Queens-Rocket-Engineering-Team/GSE-ESP32/QRET-ESP32.kicad_pcb

## KiCad design QRET-ESP32.kicad_pcb (2026-04-01)

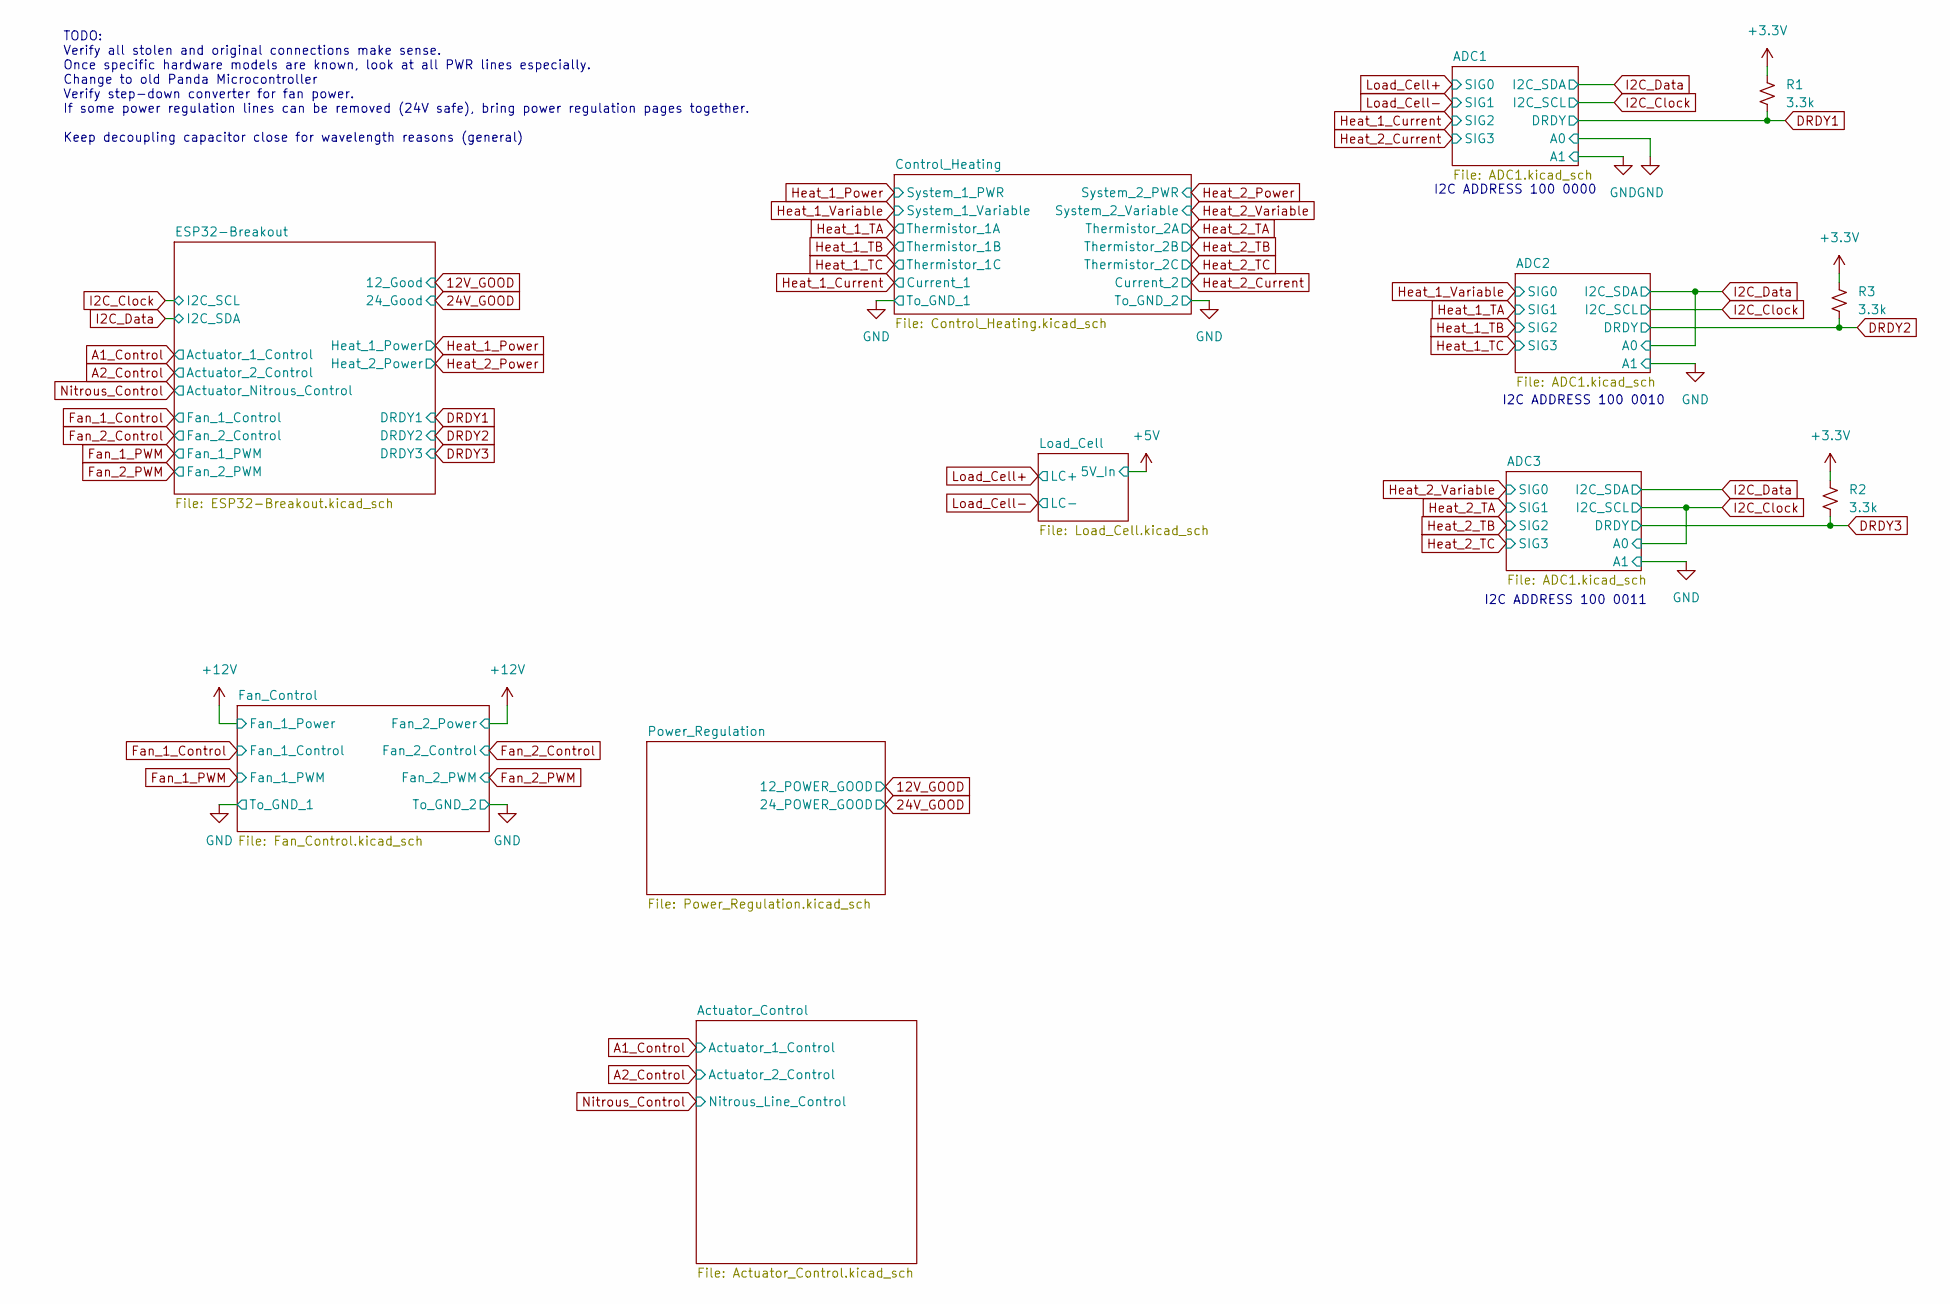
[picture p1: schematic QRET-ESP32.kicad_sch]

Parts:
R1, R2, R3: 3.3k; R_0402_1005Metric

Connections:
DRDY1: R1.2; also elsewhere on the board
DRDY2: R3.2; also elsewhere on the board
DRDY3: R2.2; also elsewhere on the board

Notes on the sheet:
TODO: Verify all stolen and original connections make sense. Once specific hardware models are known, look at all PWR lines especially. Change to old Panda Microcontroller Verify step-down converter for fan power. If some power regulation lines can be removed (24V safe), bring power regulation page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
I2C ADDRESS 100 0000
I2C ADDRESS 100 0011
I2C ADDRESS 100 0010

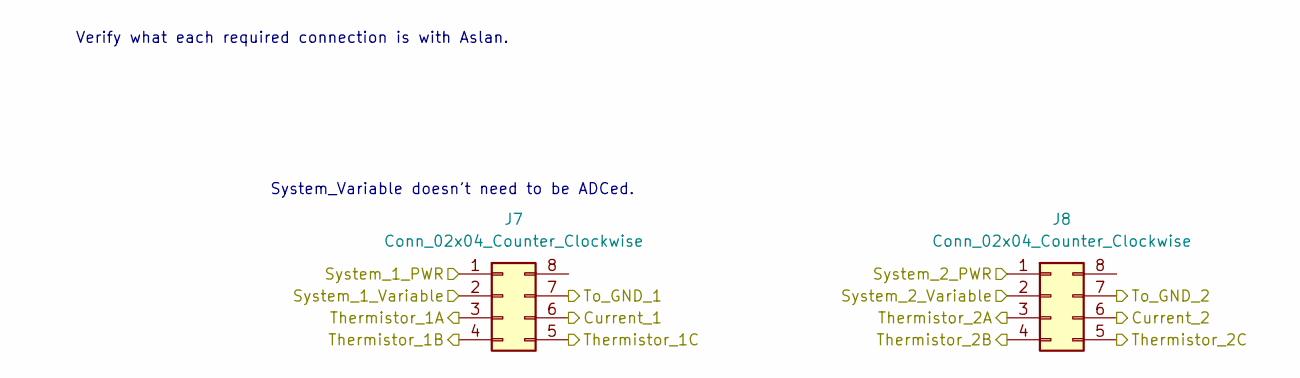
[picture p2: schematic Control_Heating.kicad_sch]

Parts:
J7, J8: Conn_02x04_Counter_Clockwise; JST_J2100_B08B-J21DK-GGXR_2x04_P2.50x4.00mm_Vertical

Connections:
Heat_1_Current: J7.6; also elsewhere on the board
Heat_1_Power: J7.1; also elsewhere on the board
Heat_1_TA: J7.3; also elsewhere on the board
Heat_1_TB: J7.4; also elsewhere on the board
Heat_1_TC: J7.5; also elsewhere on the board
Heat_1_Variable: J7.2; also elsewhere on the board
Heat_2_Current: J8.6; also elsewhere on the board
Heat_2_Power: J8.1; also elsewhere on the board
Heat_2_TA: J8.3; also elsewhere on the board
Heat_2_TB: J8.4; also elsewhere on the board
Heat_2_TC: J8.5; also elsewhere on the board
Heat_2_Variable: J8.2; also elsewhere on the board

Notes on the sheet:
Verify what each required connection is with Aslan.
System_Variable doesn't need to be ADCed.

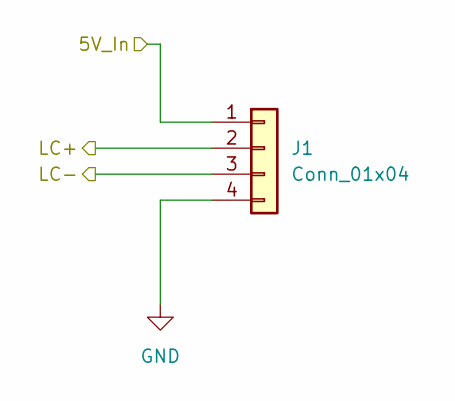
[picture p3: schematic Load_Cell.kicad_sch]

Parts:
J1: Conn_01x04; JST_EH_B4B-EH-A_1x04_P2.50mm_Vertical

Connections:
+5V: J1.1; also elsewhere on the board
Load_Cell+: J1.2; also elsewhere on the board
Load_Cell-: J1.3; also elsewhere on the board

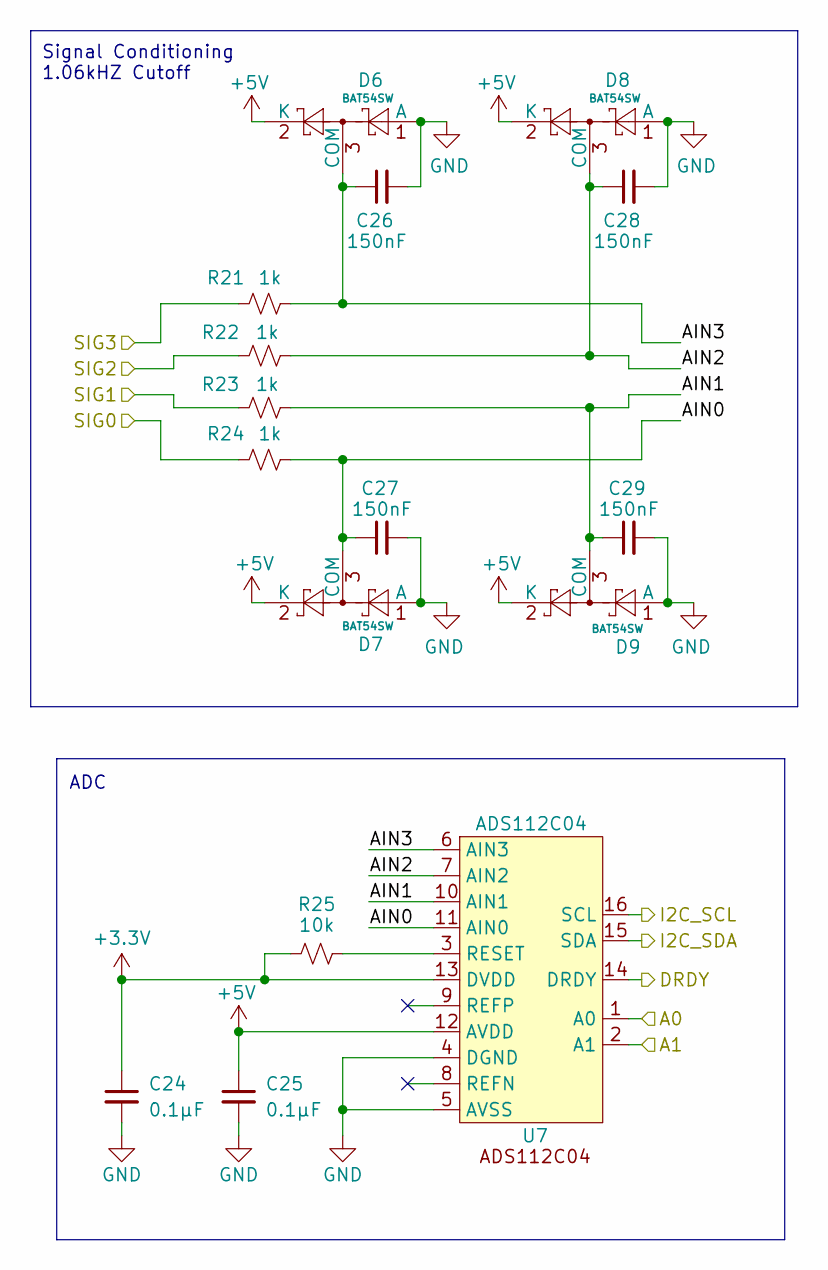
[picture p4: schematic ADC1.kicad_sch]

Parts:
C24, C25: 0.1μF; C_0402_1005Metric; MPN CL05B104KO5NNNC; LCSC C307331
C26, C27, C28, C29: 150nF; C_0402_1005Metric; LCSC C576725
D6, D7, D8, D9: BAT54SW; SOT-323_SC-70; LCSC C83575
R21, R22, R23, R24: 1k; R_0402_1005Metric
R25: 10k; R_0402_1005Metric; MPN 0402WGJ0103TCE; LCSC C25531
U7: ADS112C04; TSSOP-16_4.4x5mm_P0.65mm; MPN ADS112C04IPWR; LCSC C701615

Connections:
+5V: C25.1, D6.2 (K), D7.2 (K), D8.2 (K), D9.2 (K), U7.12 (AVDD); also elsewhere on the board
/ADC1/AIN0: C27.1, D7.3 (COM), R24.2, U7.11 (AIN0)
/ADC1/AIN1: C29.1, D9.3 (COM), R23.2, U7.10 (AIN1)
/ADC1/AIN2: C28.1, D8.3 (COM), R22.2, U7.7 (AIN2)
/ADC1/AIN3: C26.1, D6.3 (COM), R21.2, U7.6 (AIN3)
DRDY1: U7.14 (DRDY); also elsewhere on the board
Heat_1_Current: R22.1; also elsewhere on the board
Heat_2_Current: R21.1; also elsewhere on the board
I2C_Clock: U7.16 (SCL); also elsewhere on the board
I2C_Data: U7.15 (SDA); also elsewhere on the board
Load_Cell+: R24.1; also elsewhere on the board
Load_Cell-: R23.1; also elsewhere on the board
unnamed: R25.2, U7.3 (RESET)

Parts of its further copies:
C30, C31, C36, C37: 0.1μF; C_0402_1005Metric; MPN CL05B104KO5NNNC; LCSC C307331
C32, C33, C34, C35, C38, C39, C40, C41: 150nF; C_0402_1005Metric; LCSC C576725
D10, D11, D12, D13, D14, D15, D16, D17: BAT54SW; SOT-323_SC-70; LCSC C83575
R26, R27, R28, R29, R31, R32, R33, R34: 1k; R_0402_1005Metric
R30, R35: 10k; R_0402_1005Metric; MPN 0402WGJ0103TCE; LCSC C25531
U8, U9: ADS112C04; TSSOP-16_4.4x5mm_P0.65mm; MPN ADS112C04IPWR; LCSC C701615

Connections of its further copies:
+5V: C31.1, C37.1, D10.2 (K), D11.2 (K), D12.2 (K), D13.2 (K), D14.2 (K), D15.2 (K), D16.2 (K), D17.2 (K), U8.12 (AVDD), U9.12 (AVDD); also elsewhere on the board
/ADC2/AIN0: C33.1, D11.3 (COM), R29.2, U8.11 (AIN0)
/ADC2/AIN1: C35.1, D13.3 (COM), R28.2, U8.10 (AIN1)
/ADC2/AIN2: C34.1, D12.3 (COM), R27.2, U8.7 (AIN2)
/ADC2/AIN3: C32.1, D10.3 (COM), R26.2, U8.6 (AIN3)
/ADC3/AIN0: C39.1, D15.3 (COM), R34.2, U9.11 (AIN0)
/ADC3/AIN1: C41.1, D17.3 (COM), R33.2, U9.10 (AIN1)
/ADC3/AIN2: C40.1, D16.3 (COM), R32.2, U9.7 (AIN2)
/ADC3/AIN3: C38.1, D14.3 (COM), R31.2, U9.6 (AIN3)
DRDY2: U8.14 (DRDY); also elsewhere on the board
DRDY3: U9.14 (DRDY); also elsewhere on the board
Heat_1_TA: R28.1; also elsewhere on the board
Heat_1_TB: R27.1; also elsewhere on the board
Heat_1_TC: R26.1; also elsewhere on the board
Heat_1_Variable: R29.1; also elsewhere on the board
Heat_2_TA: R33.1; also elsewhere on the board
Heat_2_TB: R32.1; also elsewhere on the board
Heat_2_TC: R31.1; also elsewhere on the board
Heat_2_Variable: R34.1; also elsewhere on the board
I2C_Clock: U8.16 (SCL), U9.1 (A0), U9.16 (SCL); also elsewhere on the board
I2C_Data: U8.1 (A0), U8.15 (SDA), U9.15 (SDA); also elsewhere on the board
unnamed: R30.2, U8.3 (RESET)
unnamed: R35.2, U9.3 (RESET)

Notes on the sheet:
ADC
Signal Conditioning 1.06kHZ Cutoff

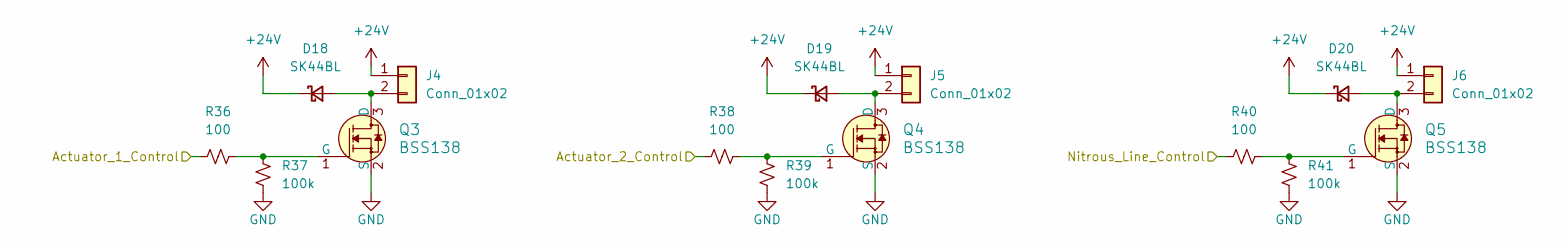
[picture p5: schematic Actuator_Control.kicad_sch]

Parts:
D18, D19, D20: SK44BL; D_SMB; MPN SK44BL-TP; LCSC C151740
J4, J5, J6: Conn_01x02; JST_EH_B2B-EH-A_1x02_P2.50mm_Vertical
Q3, Q4, Q5: BSS138; SOT-23-3; MPN BSS138; LCSC C8490
R36, R38, R40: 100; R_0402_1005Metric; MPN 0402WGF1000TCE; LCSC C25076
R37, R39, R41: 100k; R_0603_1608Metric; MPN 0402WGJ0104TCE; LCSC C25530

Connections:
+24V: D18.1 (K), D19.1 (K), D20.1 (K), J4.1, J5.1, J6.1; also elsewhere on the board
A1_Control: R36.1; also elsewhere on the board
A2_Control: R38.1; also elsewhere on the board
unnamed: D18.2 (A), J4.2, Q3.3 (D)
unnamed: D19.2 (A), J5.2, Q4.3 (D)
unnamed: D20.2 (A), J6.2, Q5.3 (D)
unnamed: Q3.1 (G), R36.2, R37.1
unnamed: Q4.1 (G), R38.2, R39.1
unnamed: Q5.1 (G), R40.2, R41.1
Nitrous_Control: R40.1; also elsewhere on the board

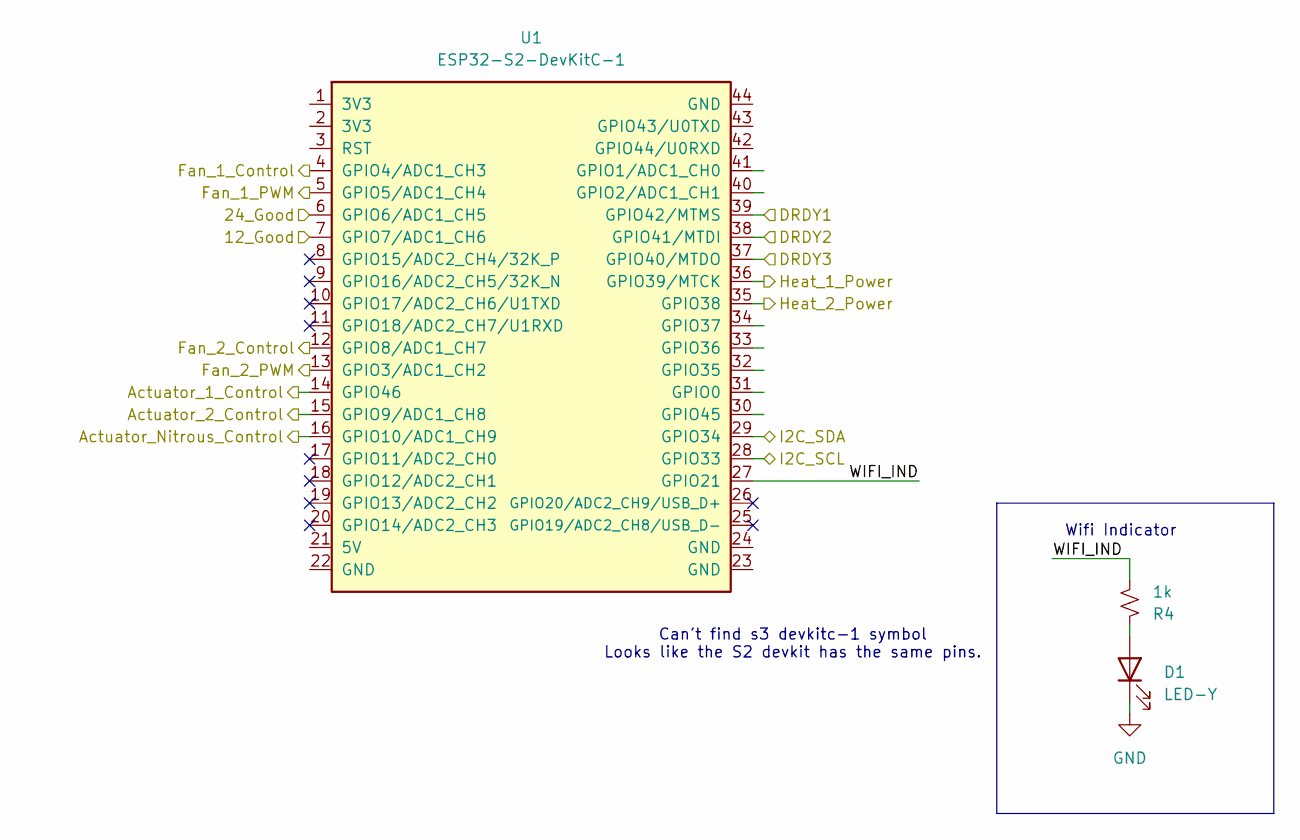
[picture p6: schematic ESP32-Breakout.kicad_sch]

Parts:
D1: LED-Y; LED_0805_2012Metric; LCSC C2296
R4: 1k; R_0402_1005Metric
U1: ESP32-S2-DevKitC-1

Connections:
12V_GOOD: U1.7 (GPIO7/ADC1_CH6); also elsewhere on the board
24V_GOOD: U1.6 (GPIO6/ADC1_CH5); also elsewhere on the board
/ESP32-Breakout/WIFI_IND: R4.2, U1.27 (GPIO21)
A1_Control: U1.14 (GPIO46); also elsewhere on the board
A2_Control: U1.15 (GPIO9/ADC1_CH8); also elsewhere on the board
DRDY1: U1.39 (GPIO42/MTMS); also elsewhere on the board
DRDY2: U1.38 (GPIO41/MTDI); also elsewhere on the board
DRDY3: U1.37 (GPIO40/MTDO); also elsewhere on the board
Fan_1_Control: U1.4 (GPIO4/ADC1_CH3); also elsewhere on the board
Fan_1_PWM: U1.5 (GPIO5/ADC1_CH4); also elsewhere on the board
Fan_2_Control: U1.12 (GPIO8/ADC1_CH7); also elsewhere on the board
Fan_2_PWM: U1.13 (GPIO3/ADC1_CH2); also elsewhere on the board
Heat_1_Power: U1.36 (GPIO39/MTCK); also elsewhere on the board
Heat_2_Power: U1.35 (GPIO38); also elsewhere on the board
I2C_Clock: U1.28 (GPIO33); also elsewhere on the board
I2C_Data: U1.29 (GPIO34); also elsewhere on the board
unnamed: D1.2 (A), R4.1
Nitrous_Control: U1.16 (GPIO10/ADC1_CH9); also elsewhere on the board

Notes on the sheet:
Can't find s3 devkitc-1 symbol Looks like the S2 devkit has the same pins.
Wifi Indicator

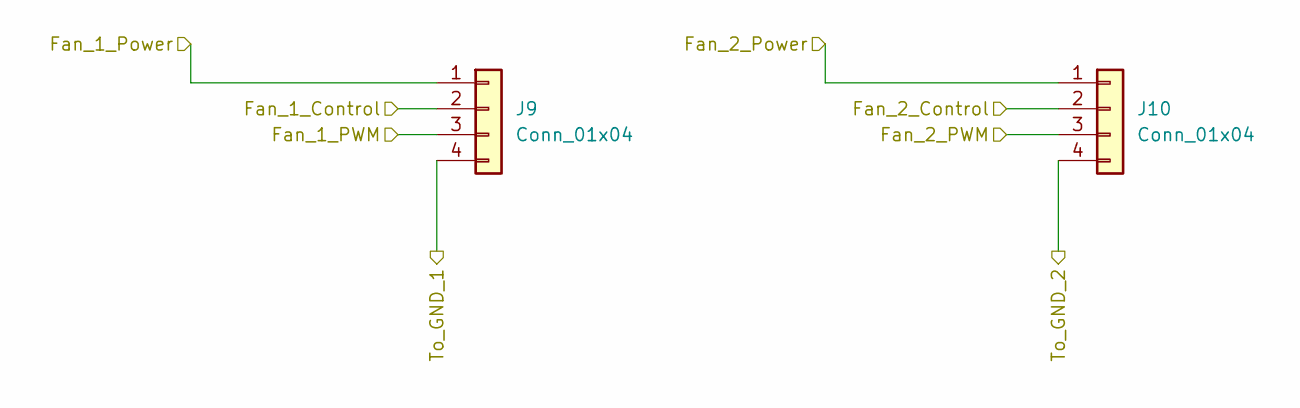
[picture p7: schematic Fan_Control.kicad_sch]

Parts:
J9, J10: Conn_01x04; JST_EH_B4B-EH-A_1x04_P2.50mm_Vertical

Connections:
+12V: J9.1, J10.1; also elsewhere on the board
Fan_1_Control: J9.2; also elsewhere on the board
Fan_1_PWM: J9.3; also elsewhere on the board
Fan_2_Control: J10.2; also elsewhere on the board
Fan_2_PWM: J10.3; also elsewhere on the board

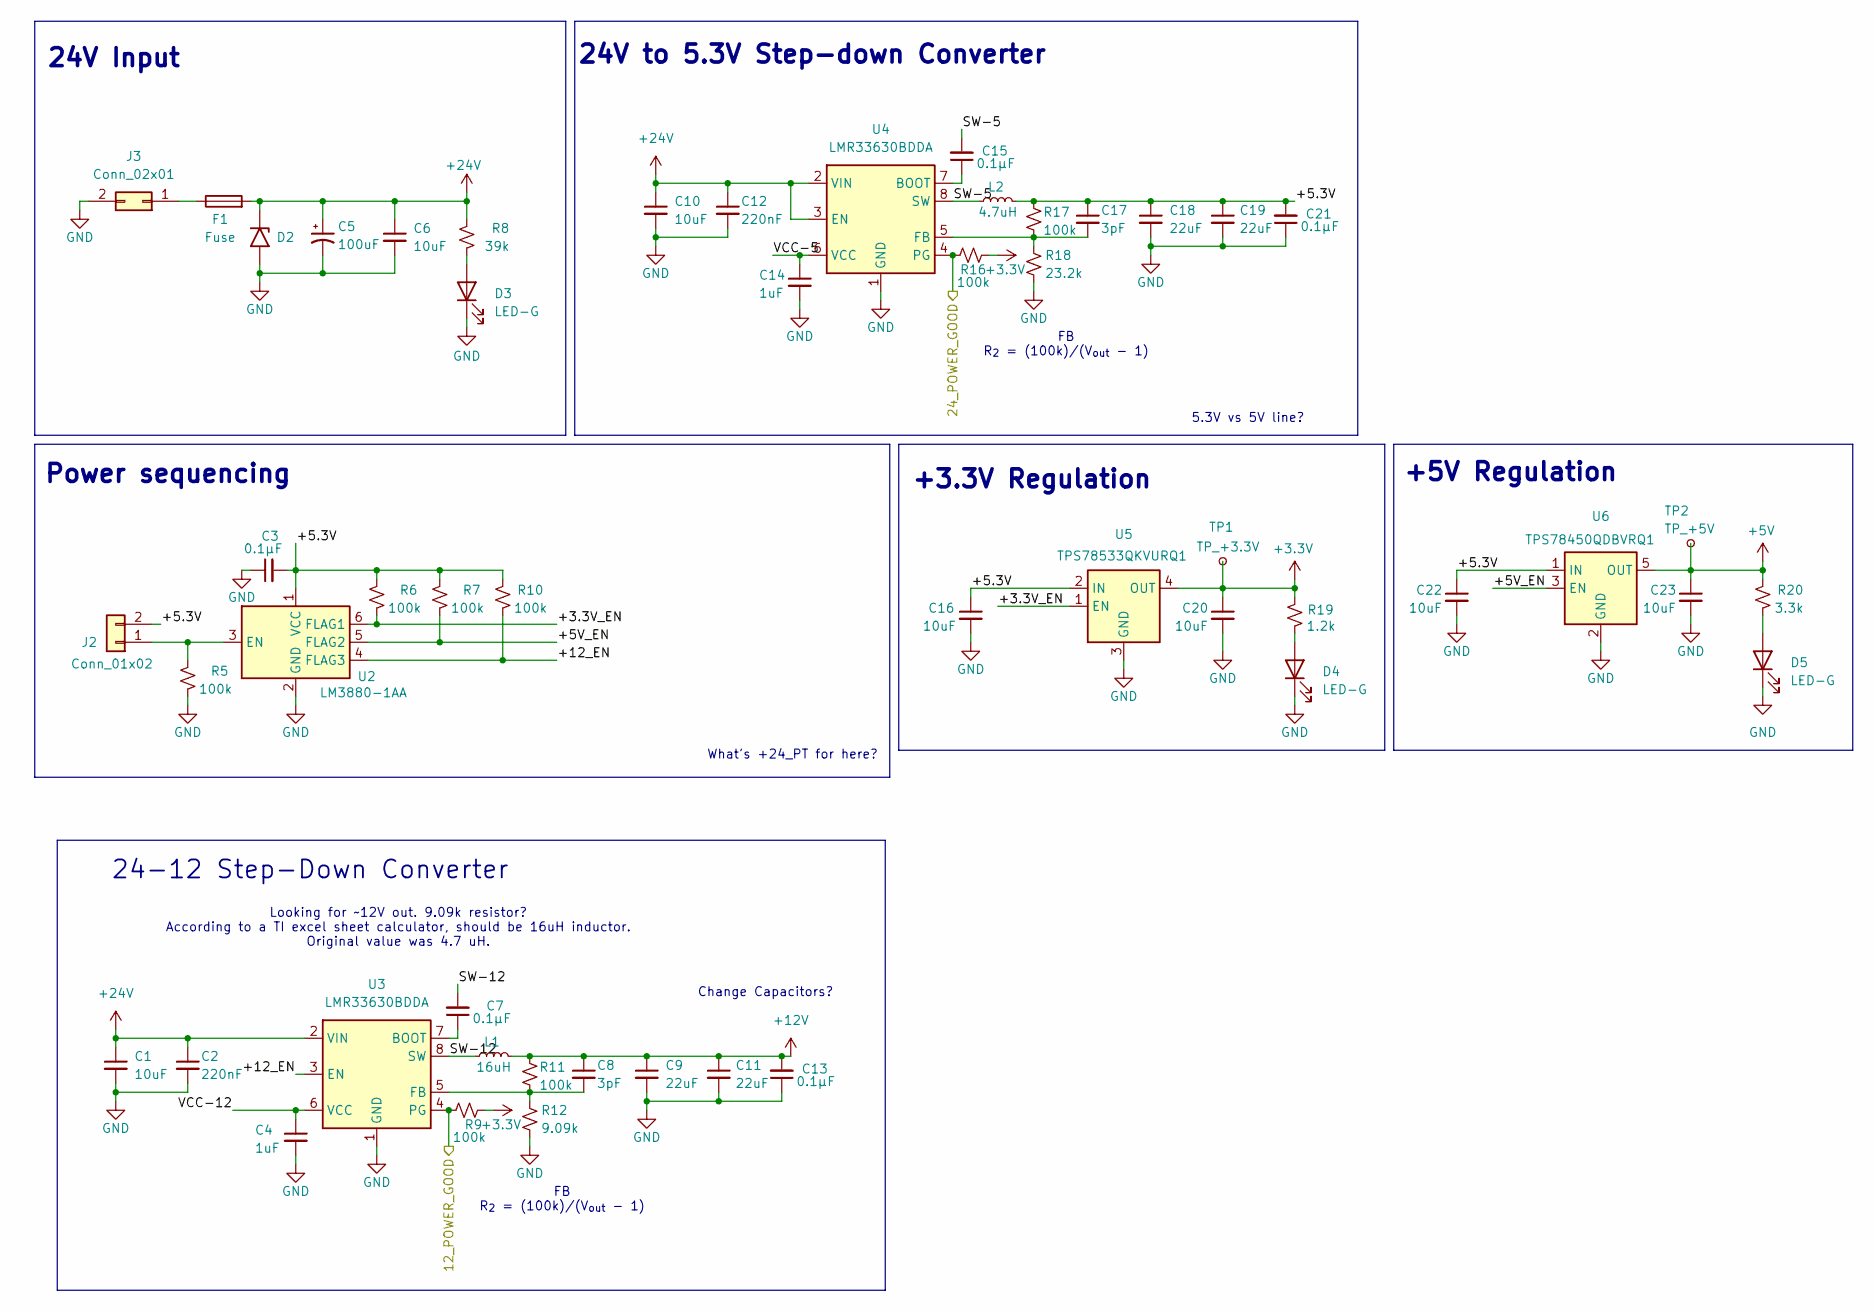
[picture p8: schematic Power_Regulation.kicad_sch]

Parts:
C1, C10: 10uF; C_1206_3216Metric; Voltage 50V; LCSC C13585
C2, C12: 220nF; C_0805_2012Metric; Voltage 50V; LCSC C5378
C3, C7, C13, C15, C21: 0.1μF; C_0402_1005Metric; MPN CL05B104KO5NNNC; LCSC C307331
C4, C14: 1uF; C_0603_1608Metric; LCSC C29936
C5: 100uF; CP_Elec_10x10; LCSC C161937
C6: 10uF; C_1812_4532Metric; Voltage 50V
C8, C17: 3pF; C_0603_1608Metric; LCSC C695157
C9, C11, C18, C19: 22uF; C_0805_2012Metric; LCSC C602037
C16, C20, C22, C23: 10uF; C_0805_2012Metric; LCSC C15850
D2: SMCJ26A-13-F; D_SMC; LCSC C135156
D3, D4, D5: LED-G; LED_0805_2012Metric; LCSC C2297
F1: Fuse; Fuseholder_Blade_Mini_Keystone_3568
J2: Conn_01x02; Molex_Micro-Fit_3.0_43650-0215_1x02_P3.00mm_Vertical
J3: Conn_02x01; Molex_Mini-Fit_Jr_5566-02A_2x01_P4.20mm_Vertical
L1: 16uH; L_Bourns_SRP7028A_7.3x6.6mm; LCSC C840529
L2: 4.7uH; L_Bourns_SRP7028A_7.3x6.6mm; LCSC C840529
R5, R6, R7, R10: 100k; R_0603_1608Metric
R8: 39k; R_0402_1005Metric
R9, R11, R16, R17: 100k; R_0603_1608Metric; MPN 0402WGJ0103TCE; LCSC C25531
R12: 9.09k; R_0603_1608Metric; MPN 0402WGF3301TCE; LCSC C25890
R18: 23.2k; R_0603_1608Metric; MPN 0402WGF3301TCE; LCSC C25890
R19: 1.2k; R_0402_1005Metric
R20: 3.3k; R_0402_1005Metric
TP1: TP_+3.3V; TestPoint_Pad_D1.0mm
TP2: TP_+5V; TestPoint_Pad_D1.0mm
U2: LM3880-1AA; SOT-23-6; LCSC C486059
U3, U4: LMR33630BDDA; Texas_HSOP-8-1EP_3.9x4.9mm_P1.27mm_ThermalVias; LCSC C544370
U5: TPS78533QKVURQ1; TO-252-4; LCSC C3748131
U6: TPS78450QDBVRQ1; SOT-23-5; LCSC C2877783

Connections:
12V_GOOD: R9.1, U3.4 (PG); also elsewhere on the board
24V_GOOD: R16.1, U4.4 (PG); also elsewhere on the board
+5V: C23.1, R20.2, TP2.1, U6.5 (OUT); also elsewhere on the board
+12V: C8.1, C9.1, C11.1, C13.2, L1.2, R11.1; also elsewhere on the board
+24V: C1.1, C2.1, C5.1, C6.1, C10.1, C12.1, D2.1 (A1), F1.2, R8.2, U3.2 (VIN), U4.2 (VIN), U4.3 (EN); also elsewhere on the board
/Power_Regulation/+3.3V_EN: R6.1, U2.6 (FLAG1), U5.1 (EN)
/Power_Regulation/+5.3V: C3.2, C16.1, C17.1, C18.1, C19.1, C21.2, C22.1, J2.2, L2.2, R6.2, R7.2, R10.2, R17.1, U2.1 (VCC), U5.2 (IN), U6.1 (IN)
/Power_Regulation/+5V_EN: R7.1, U2.5 (FLAG2), U6.3 (EN)
/Power_Regulation/+12_EN: R10.1, U2.4 (FLAG3), U3.3 (EN)
/Power_Regulation/SW-5: C15.2, L2.1, U4.8 (SW)
/Power_Regulation/SW-12: C7.2, L1.1, U3.8 (SW)
/Power_Regulation/VCC-5: C14.1, U4.6 (VCC)
/Power_Regulation/VCC-12: C4.1, U3.6 (VCC)
unnamed: D3.2 (A), R8.1
unnamed: D4.2 (A), R19.1
unnamed: D5.2 (A), R20.1
unnamed: J2.1, R5.2, U2.3 (EN)
unnamed: F1.1, J3.1
unnamed: C7.1, U3.7 (BOOT)
unnamed: C8.2, R11.2, R12.1, U3.5 (FB)
unnamed: C15.1, U4.7 (BOOT)
unnamed: C17.2, R17.2, R18.1, U4.5 (FB)

Notes on the sheet:
24V Input
5.3V vs 5V line?
24V to 5.3V Step-down Converter
What's +24_PT for here?
FB R_{2} = (100k)/(V_{out} - 1)
+3.3V Regulation
Change Capacitors?
Power sequencing
+5V Regulation
Looking for ~12V out. 9.09k resistor? According to a TI excel sheet calculator, should be 16uH inductor. Original value was 4.7 uH.
24-12 Step-Down Converter

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
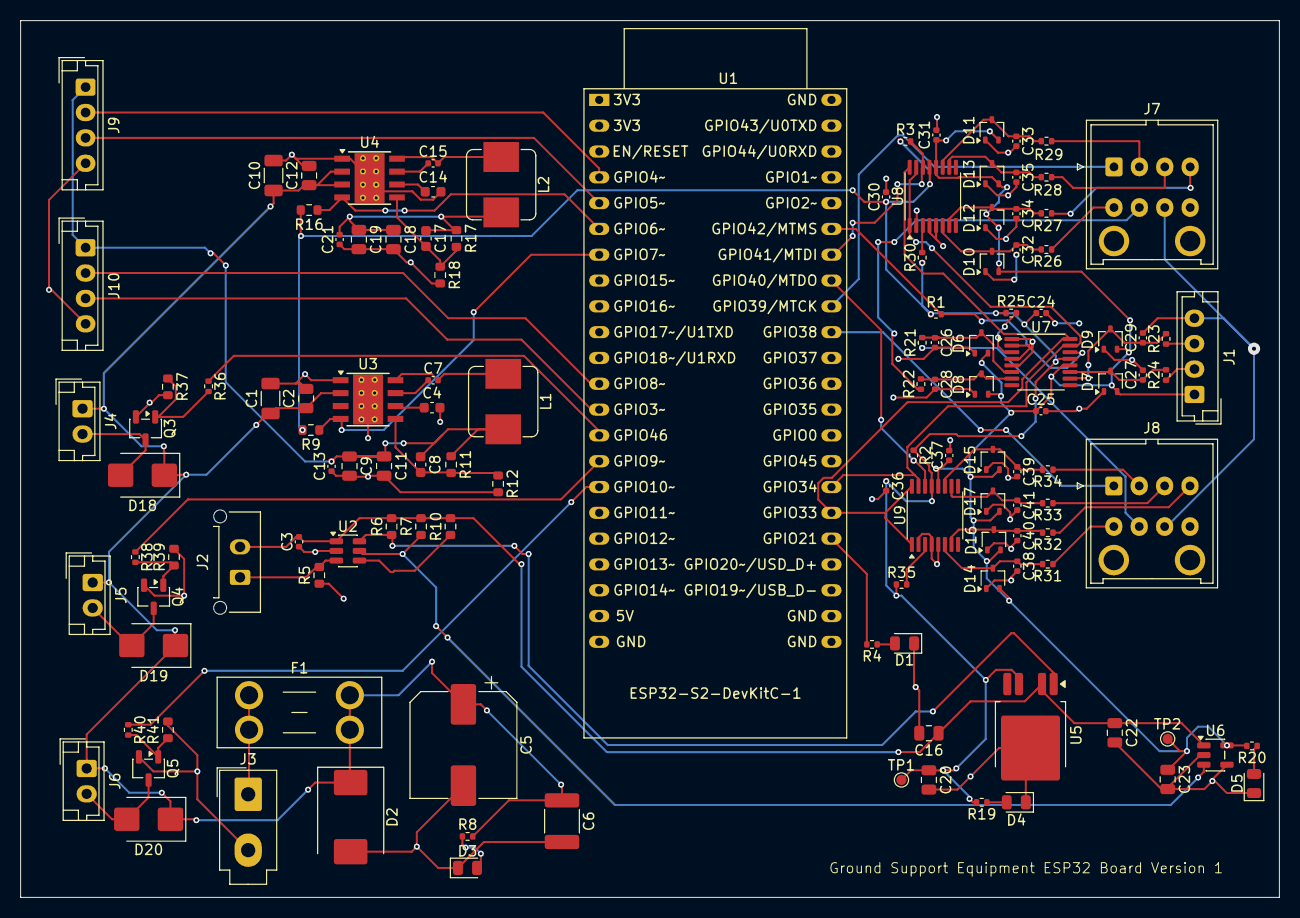
[picture p9: board QRET-ESP32.kicad_pcb from above]

Board: 4 copper layers, 123.9 x 86.3 mm, 126 parts (0 on the bottom side), 73 nets.
