Queens-Rocket-Engineering-Team/GSE-ESP32/(commit log)

2026-01-29 Stole a bunch more stuff from PANDA, added fan and heating line
    [QRET-ESP32.kicad_sch]
2026-01-29 Actually included new files hopefully
    [ADC1.kicad_sch, Actuator_Control.kicad_sch, Control_Heating.kicad_sch, ESP32-Breakout.kicad_sch, Fan_Control.kicad_sch, Load_Cell.kicad_sch, Old_Reference.kicad_sch, Power_Regulation.kicad_sch]
2026-02-02 Updated most of root-page labels.
    [Actuator_Control.kicad_sch, ESP32-Breakout.kicad_sch, Fan_Control.kicad_sch, QRET-ESP32.kicad_sch]
2026-02-06 Added 24V-12V step-down converter for fans, started switch to devkit.
    [Control_Heating.kicad_sch, ESP32-Breakout.kicad_sch, Fan_Control.kicad_sch, Power_Regulation_2.kicad_sch, QRET-ESP32.kicad_sch]
2026-02-19 Updated to 4-pin fans, moved power pages together, deleted old reference.
    [ADC1.kicad_sch, Actuator_Control.kicad_sch, Control_Heating.kicad_sch, ESP32-Breakout.kicad_sch, Fan_Control.kicad_sch, Load_Cell.kicad_sch, Power_Regulation.kicad_sch, QRET-ESP32.kicad_pcb]
2026-02-19 Removed unnecessary files.
    [Old_Reference.kicad_sch, Power_Regulation_2.kicad_sch]
2026-03-17 Started placement of ADC1 and 2.
    [QRET-ESP32.kicad_pcb]
2026-03-25 Adopted 4-layer setup and organized placement
    [ESP32-Breakout.kicad_sch, Power_Regulation.kicad_sch, QRET-ESP32.kicad_pcb, QRET-ESP32.kicad_sch]
2026-03-29 Initial PCB placement and wiring.
    [ESP32-Breakout.kicad_sch, Power_Regulation.kicad_sch, QRET-ESP32.kicad_pcb, QRET-ESP32.kicad_sch]
2026-04-01 Updated power regulation, To-Do: Rewire PCB
    [Power_Regulation.kicad_sch, QRET-ESP32.kicad_pcb]
